lawabb/ESPrinkler2/docs/Screenshot_20190603-192318.png

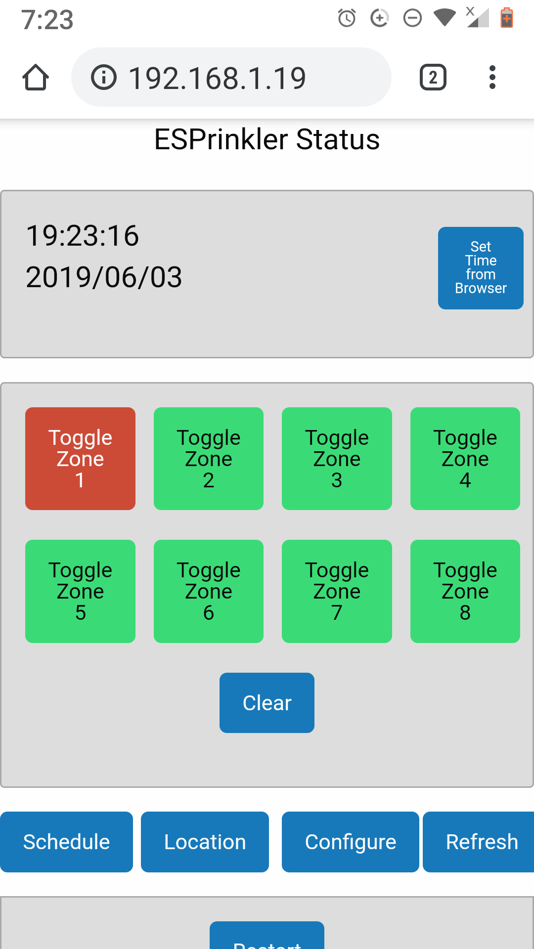
docs/Screenshot_20190603-192318.png
