lawabb/ESPrinkler2/docs/ESPrinkler-Schem_20180705100240.pdf

## VCC

CN4 1

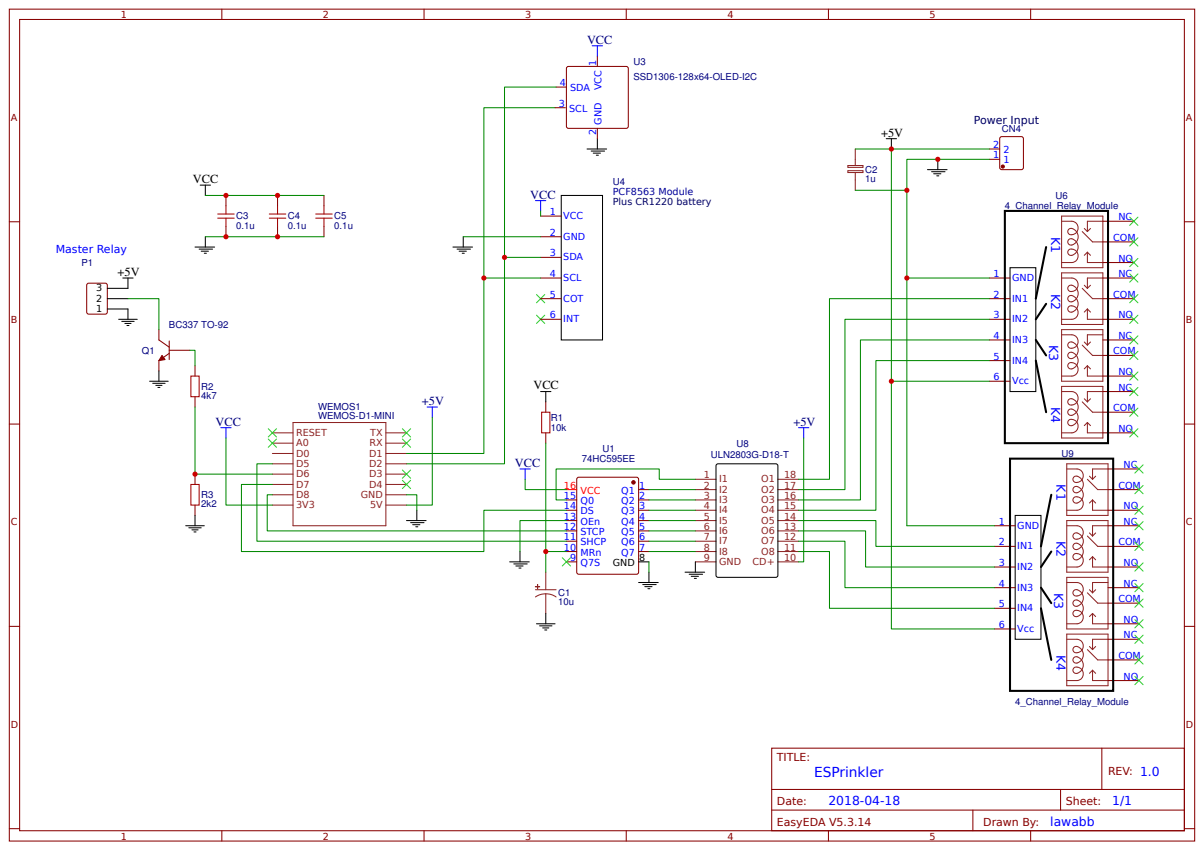
[picture p3: page 1]

9 MRn 10 SHCP 11 STCP 12 OEn 13 DS 14 Q0 15 VCC 16
