lawabb/ESPrinkler2/docs/mini_new_v2_2_0.pdf

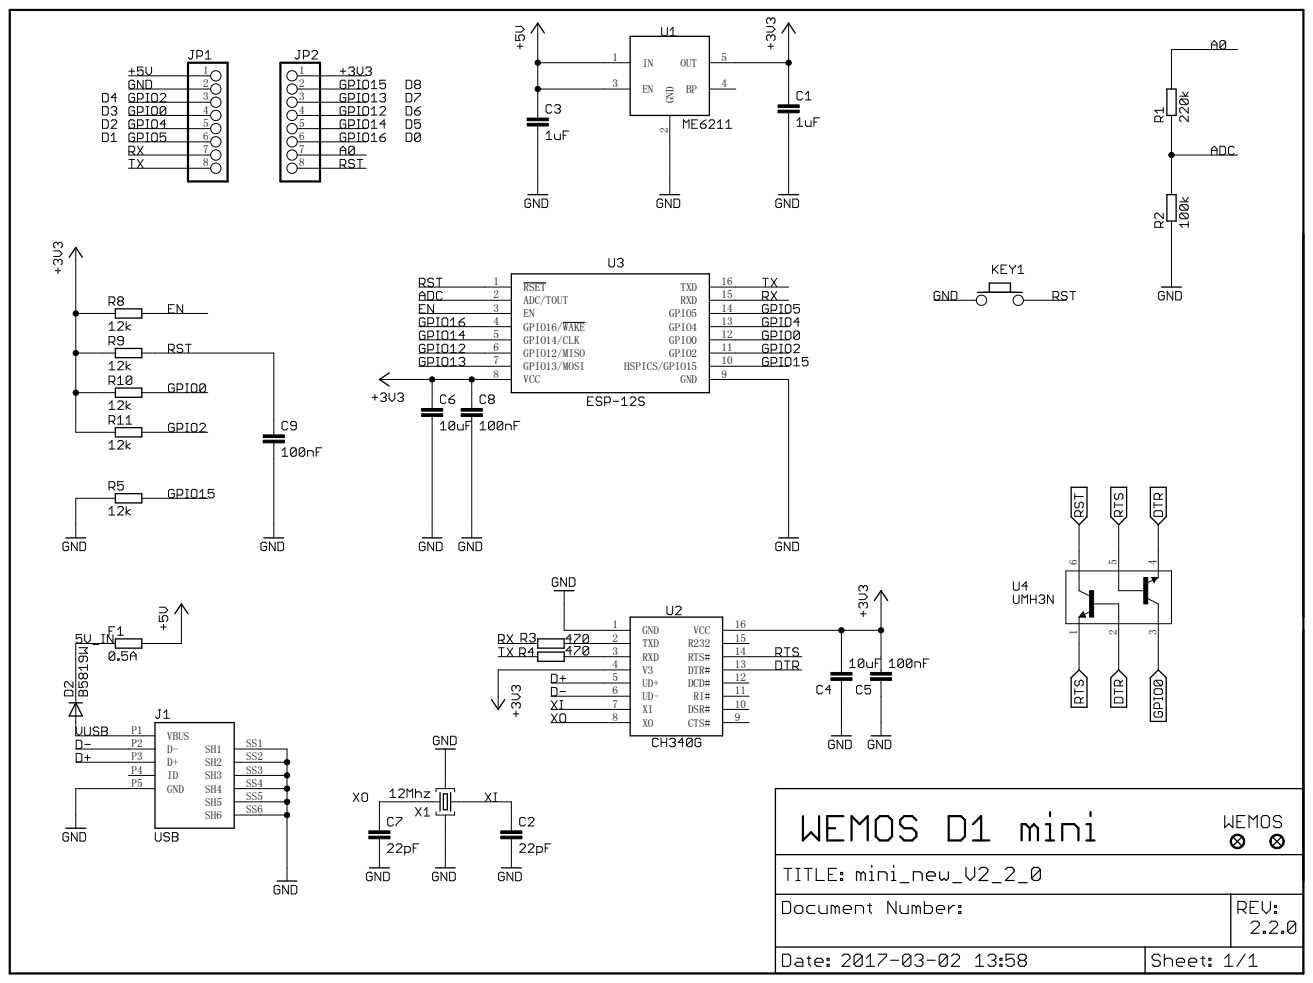
[picture p4: page 1]
