lawabb/ESPrinkler2/ESPrinkler2.ino

/*
 ESPrinkler2 -- Web Server Enabled Sprinkler Controller
 https://github.com/n0bel/ESPrinkler2
 Original Base code is https://github.com/esp8266/Arduino/blob/master/libraries/ESP8266WebServer/examples/FSBrowser/FSBrowser.ino
 Base Code Copyright (c) 2015 Hristo Gochkov. All rights reserved. LGPL
 This Code Copyright (c) 2017 Kevin Uhlir. All rights reserved. LGPL
 This is a rewrite of ESPrinkler https://github.com/n0bel/ESPrinkler but based
 on the Arduino toolchain instead of ExperssIF.  This should make the project
 more accessable to people.
  Minor modifications by Lawrie Abbott 2018. lawabb@gmail.com
*/

/* Requirements:
  Arduino-1.8.5 - this what I used.  Others may be OK
  ESP8266/Arduino :Current Additional Boards Manager URL: https://github.com/esp8266/esp8266.github.io
    Version 2.5.2 https://github.com/esp8266/esp8266.github.io/blob/c6ddb5c67bbc11052dcc4d3c872d92c874f97bed/stable/package_esp8266com_index.json
  ESP8266/Arduino 2.5.2 https://github.com/esp8266/Arduino/releases/tag/2.5.2
  Time 1.5.0 https://github.com/PaulStoffregen/Time
  SimpleTimer https://github.com/jfturcot/SimpleTimer (http://playground.arduino.cc/Code/SimpleTimer)
  NtpClientLib 2.0.5 https://github.com/gmag11/NtpClient
  ArduinoJson 5.6.7 https://github.com/bblanchon/ArduinoJson (https://bblanchon.github.io/ArduinoJson/)
  U8G2Lib 2.13.5 https://github.com/olikraus/u8g2
  orbitalair-arduino-rtc-pcf8563  https://bitbucket.org/orbitalair/arduino_rtc_pcf8563/downloads/ (https://playground.arduino.cc/Main/RTC-PCF8563)

  Don't forget to restart the Arduino IDE after installing these things.

  Set your esp settings.. the board, program method, flash size and spiffs size.

  This uses the SPIFFS file system.  So we need to load that in your esp-xx first.
  Upload the contents of the data folder with MkSPIFFS Tool ("ESP8266 Sketch Data Upload" in Tools menu in Arduino IDE)

  Then compile and upload the .ino.
*/
#define OLED_SCL D1      // D1/GPIO5/SCL to SCL
#define OLED_SDA D2      // D2/GPIO4/SDA to SDA
#define masterRelay D6   // D6/GPIO12 - Use external pulldown to avoid startup pulse 
#define PIN_CLOCK D5     // D5/GPIO14 to SH_CP (pin11 74HC595)
#define PIN_DATA D7      // D7/GPIO13 to DS (pin14 74HC595) 
#define PIN_LATCH D8     // D8/GPIO15 to ST_CP (pin12 74HC595)

#include <U8x8lib.h>
#include <u8g2.h>
#include <U8g2lib.h>
#include <u8x8.h>


// ****** Configurable Options ******

// Include code for PCF8563 RTC
#define INCLUDE_PCF8563

// Include code for DS1307 RTC
//#define INCLUDE_DS1307

// Set display
// See https://github.com/olikraus/u8g2/wiki/u8g2setupcpp#constructor-name
// U8G2_SSD1306_128X64_NONAME_F_HW_I2C(rotation, [reset [, clock, data]])
U8G2_SSD1306_128X64_NONAME_F_HW_I2C u8g2(U8G2_R0, U8X8_PIN_NONE, OLED_SCL, OLED_SDA);

// Where Do you want to send debug output?
#define DBG_OUTPUT_PORT Serial
#define DBG_OUTPUT_PORT_SPEED 115200

// Uncommment if you'd like even more debug information
// #define EXTRA_DEBUG  // arduino-1.8.5/libraries/SimpleTimer/SimpleTimer.h:103:40: error: 'void (* SimpleTimer::callbacks [10])()' is private timer_callback callbacks[MAX_TIMERS];

// ***** End of Config ******


#include <ESP8266WiFi.h>
#include <WiFiClient.h>
#include <ESP8266WebServer.h>
#include <ESP8266mDNS.h>
#include <ArduinoOTA.h>
#include <DNSServer.h>
#include <TimeLib.h>
#include <NtpClientLib.h>
#include <FS.h>..
#include <stdarg.h>

#include <ArduinoJson.h>
#include <string.h>
#include <SimpleTimer.h>
#include <Wire.h>
#include <EEPROM.h>
#define EEPROM_SIZE 512

#ifdef INCLUDE_PCF8563
#include <Rtc_Pcf8563.h>
#endif
#ifdef INCLUDE_DS1307.
#include <RtcDS1307.h>
#endif

#include "./version.h"

#ifdef INCLUDE_PCF8563
Rtc_Pcf8563 Rtc_Pcf8563;
#endif

#ifdef INCLUDE_DS1307
RtcDS1307<TwoWire> Rtc_Ds1307(Wire);
#endif

const char* configFile = "/config.json";   // The config file name
const char* schedFile = "/sched.json";   // The sched file name6
const char* buttonsFile = "/buttons.json";   // The buttons file name

// Note that these are the default values if no /config.json exists,
//  or items are missing from it.

char ssid[31] = { "" };              // This is the access point to connect to
#define EEPROM_SSID 0                 // where the ssid is kept in EEPROM
char password[31] = { "" };           // And its password
#define EEPROM_PASSWORD 32            // where the password is kept in EEPROM
char host[31] = { "*" };               // The host name .local (mdns) hostname
#define EEPROM_HOST 64                // where the host is kept in EEPROM
char assid[31] = { "" };              // This is the access point to connect to
char apassword[31] = { "" };          // And its password

int offsetGMT = 0;                    // Local timezone offset in seconds
char offsetGMTstring[10] = { "-1" };  // String version of it
#define EEPROM_OFFSET_GMT 96          // where the host is kept in EEPROM
int relayState = 0;                   // The current state of the relayState

bool apMode = false;                  // Are we in Acess Point mode?
bool dnsStarted = false;              // Did we start dns?
#ifdef INCLUDE_PCF8563
bool hasPcf8563 = false;              // we found a PCF8563
#endif
#ifdef INCLUDE_DS1307
bool hasDs1307 = false;              // we found a PCF8563
#endif
bool hasRtc = false;                  // do we have an rtc
bool rtcValid  = false;               // does it have a valid time
time_t bootTime = 0;
String bootTimeString;

char timeServer[31] = { "pool.ntp.org" };   // the NTP timeServer to use

#define MAX_SCHED 30
struct _sched {
  int zone;       // 1-8 and 100 for reset
  int days;       // day bits 0-6 = sunday-saturday and 8 and 9 are even and odd
  time_t start;   // seconds like 02:00 am is 120 * 3600
  int duration;   // minutes
  time_t begin;   // begin date
  time_t end;     // end date
  time_t next;    // next time this should turn on a relay
  time_t stop;    // when the relay should turn off
} sched[MAX_SCHED] = { 0 };


// DNS server
const byte DNS_PORT = 53;
DNSServer dnsServer;

ESP8266WebServer server(80);  // The Web Server
File fsUploadFile;            // holds the current upload when files are
                              // uploaded (see edit.htm)
SimpleTimer timer;

int priorPct = -1;
int fullSize = -1;

// format bytes
String formatBytes(size_t bytes) {
  if (bytes < 1024) {
    return String(bytes)+"B";
  } else if (bytes < (1024 * 1024)) {
    return String(bytes/1024.0)+"KB";
  } else if (bytes < (1024 * 1024 * 1024)) {
    return String(bytes/1024.0/1024.0)+"MB";
  } else {
    return String(bytes/1024.0/1024.0/1024.0)+"GB";
  }
}

String getContentType(String filename) {
  if (server.hasArg("download")) return "application/octet-stream";
  else if (filename.endsWith(".htm")) return "text/html";
  else if (filename.endsWith(".html")) return "text/html";
  else if (filename.endsWith(".css")) return "text/css";
  else if (filename.endsWith(".js")) return "application/javascript";
  else if (filename.endsWith(".json")) return "text/json";
  else if (filename.endsWith(".png")) return "image/png";
  else if (filename.endsWith(".gif")) return "image/gif";
  else if (filename.endsWith(".jpg")) return "image/jpeg";
  else if (filename.endsWith(".ico")) return "image/x-icon";
  else if (filename.endsWith(".xml")) return "text/xml";
  else if (filename.endsWith(".pdf")) return "application/x-pdf";
  else if (filename.endsWith(".zip")) return "application/x-zip";
  else if (filename.endsWith(".gz")) return "application/x-gzip";
  return "text/plain";
}

bool handleFileRead(String path) {
  DBG_OUTPUT_PORT.printf(" handleFileRead: %s\n",
    path.c_str());
  displayStatus(2, "served %s", path.c_str());
  if (path.endsWith("/")) path += "index.html";
  String ims = server.header("If-Modified-Since");
  String contentType = getContentType(path);
  String pathWithGz = path + ".gz";
  if (SPIFFS.exists(pathWithGz) || SPIFFS.exists(path)) {
    if (bootTimeString != "" && bootTimeString == ims) {
      server.send(304, contentType, "Not Modified");
      return true;
    }
    if (SPIFFS.exists(pathWithGz))
      path += ".gz";
    File file = SPIFFS.open(path, "r");
    if (path.indexOf(".json") < 0 || path.indexOf("-schema.json") > -1) {
        server.sendHeader("Cache-Control", "public, max-age=3600");
        if (bootTime > 0) {
          server.sendHeader("Last-Modified", bootTimeString);
        }
    } else {
      server.sendHeader("Cache-Control", "public, max-age=0");
    }
    size_t sent = server.streamFile(file, contentType);
    file.close();
    return true;
  }
  DBG_OUTPUT_PORT.printf("%s not found\n", path.c_str());
  return false;
}

void handleFileUpdate() {
  HTTPUpload& update = server.upload();
  if (update.status == UPLOAD_FILE_START) {
    String filename = update.filename;
    fullSize = atoi(server.header("Content-Length").c_str());
    priorPct = 0;
    DBG_OUTPUT_PORT.printf("handleFileUpdate Name: %s %d\n",
      filename.c_str(), fullSize);
    displayStatus(1, "HTTP Update start");
    if (server.uri() == "/spiffsupdate") {
      if (!Update.begin(fullSize, U_SPIFFS)) {
        Update.printError(DBG_OUTPUT_PORT);
      }
    } else {
      uint32_t maxSketchSpace = (ESP.getFreeSketchSpace() - 0x1000)
        & 0xFFFFF000;
      if (!Update.begin(maxSketchSpace)) {
        Update.printError(DBG_OUTPUT_PORT);
      }
    }
  } else if (update.status == UPLOAD_FILE_WRITE) {
    int p = update.totalSize / (fullSize / 100);
    if ((p - priorPct) >= 5) {
      priorPct = p;
      DBG_OUTPUT_PORT.printf("Update: %u%%\n", p);
      displayStatus(1, "HTTP Update %u%", p);
    }
    if (Update.write(update.buf, update.currentSize) != update.currentSize) {
      Update.printError(DBG_OUTPUT_PORT);
      displayStatus(1, "HTTP Update Failed");
    }
  } else if (update.status == UPLOAD_FILE_END) {
    if (Update.end(true)) {
      DBG_OUTPUT_PORT.printf("Update Success: %u\nRebooting...\n",
        update.totalSize);
      displayStatus(1, "HTTP Update End");
    } else {
      Update.printError(DBG_OUTPUT_PORT);
    }
  } else if (update.status == UPLOAD_FILE_ABORTED) {
    Update.end();
    DBG_OUTPUT_PORT.printf("Update aborted.\n");
    displayStatus(1, "HTTP Update aborted");
  }
}
void afterFileUpdate() {
  server.sendHeader("Location",
    String(Update.hasError() ? "/updatefailed.html" :
      "/updatesuccessful.html"), true);
  server.send(301, "text/html", "");
  doRestart();
}

void handleFileUpload() {
  if (server.uri() != "/edit") return;
  HTTPUpload& upload = server.upload();
  if (upload.status == UPLOAD_FILE_START) {
    String filename = upload.filename;
    if (!filename.startsWith("/")) filename = "/"+filename;
    displayStatus(2, "upload %s", filename.c_str());
    DBG_OUTPUT_PORT.printf("handleFileUpload Name: %s\n", filename.c_str());
    fsUploadFile = SPIFFS.open(filename, "w");
    filename = String();
  } else if (upload.status == UPLOAD_FILE_WRITE) {
    // DBG_OUTPUT_PORT.printf("handleFileUpload Data: %s\n",upload.currentSize);
    if (fsUploadFile)
      fsUploadFile.write(upload.buf, upload.currentSize);
  } else if (upload.status == UPLOAD_FILE_END) {
    if (fsUploadFile)
      fsUploadFile.close();
    DBG_OUTPUT_PORT.printf("handleFileUpload Size: %d\n", upload.totalSize);
    if (upload.filename == configFile) {
      loadConfig();
    }
    if (upload.filename == schedFile) {
      loadSched();
    }
  }
}

void handleFileDelete() {
  if (server.args() == 0) return server.send(500, "text/plain", "BAD ARGS");
  String path = server.arg(0);
  DBG_OUTPUT_PORT.printf("handleFileDelete: %s\n", path.c_str());
  displayStatus(2, "deleted %s", path.c_str());
  if (path == "/")
    return server.send(500, "text/plain", "BAD PATH");
  if (!SPIFFS.exists(path))
    return server.send(404, "text/plain", "FileNotFound");
  SPIFFS.remove(path);
  server.send(200, "text/plain", "");
  path = String();
}

void handleFileCreate() {
  if (server.args() == 0)
    return server.send(500, "text/plain", "BAD ARGS");
  String path = server.arg(0);
  DBG_OUTPUT_PORT.printf("handleFileCreate: %s\n", path.c_str());
  displayStatus(2, "created %s", path.c_str());
  if (path == "/")
    return server.send(500, "text/plain", "BAD PATH");
  if (SPIFFS.exists(path))
    return server.send(500, "text/plain", "FILE EXISTS");
  File file = SPIFFS.open(path, "w");
  if (file)
    file.close();
  else
    return server.send(500, "text/plain", "CREATE FAILED");
  server.send(200, "text/plain", "");
  path = String();
}

void handleFileList() {
  if (!server.hasArg("dir")) {
    server.send(500, "text/plain", "BAD ARGS"); return;
  }

  String path = server.arg("dir");
  DBG_OUTPUT_PORT.printf(" handleFileList: %s\n", path.c_str());
  displayStatus(2, "list %s", path.c_str());
  Dir dir = SPIFFS.openDir(path);
  path = String();

  String output = "[";
  while (dir.next()) {
    File entry = dir.openFile("r");
    if (output != "[") output += ',';
    bool isDir = false;
    output += "{\"type\":\"";
    output += (isDir)?"dir":"file";
    output += "\",\"name\":\"";
    output += String(entry.name()).substring(1);
    output += "\"}";
    entry.close();
  }

  output += "]";
  server.sendHeader("Cache-Control", "public, max-age=0");
  server.send(200, "text/json", output);
}

void eeSave();  // forward ref
void loadConfig() {
  if (SPIFFS.exists(configFile)) {
    File file = SPIFFS.open(configFile, "r");
    char json[500];
    memset(json, 0, sizeof(json));
    file.readBytes(json, sizeof(json));
    file.close();
    StaticJsonBuffer<500> jsonBuffer;
    JsonObject& root = jsonBuffer.parseObject(json);
    if (!root.success()) {
        DBG_OUTPUT_PORT.printf("json parse of configFile failed.\n");
    } else {
      const char *t;
      t = root["ssid"]; if (t && t[0] != '*') {
        strncpy(ssid, t, 30);
        t = root["password"]; if (t) { strncpy(password, t, 30); }
      }
      t = root["assid"]; if (t) { strncpy(assid, t, 30); }
      t = root["apassword"]; if (t) { strncpy(apassword, t, 30); }
      t = root["host"]; if (t) { strncpy(host, t, 30); }
      t = root["timeServer"]; if (t) { strncpy(timeServer, t, 30); }
      t = root["offsetGMT"]; if (t) { strncpy(offsetGMTstring, t, 10); }
      int g = atoi(offsetGMTstring);
      if (g != -1) {
        offsetGMT = g;
      }
      setHostName();
      displayStatus(2, host);
      eeSave();
      DBG_OUTPUT_PORT.printf("Config: host: %s ssid: %s assid: %s\n",
        host, ssid, assid);
      DBG_OUTPUT_PORT.printf("  timeServer: %s offsetGMT:%d\n",
        timeServer, offsetGMT);
    }
  } else {
    DBG_OUTPUT_PORT.printf("config file: %s not found\n", configFile);
  }
}

int computeDayFromTm(tmElements_t *tm) {
  // bits 0-6 = day of week
  // bits 8 == even Day
  // bit 9 == odd Day
  return (1 << (tm->Wday - 1)) | ( 1 << ((tm->Day & 1) + 8));
}

#ifdef EXTRA_DEBUG
void dumpSched(const char *m, struct _sched *s) {
  DBG_OUTPUT_PORT.printf(
    "%s: %08x z:%d s:%d d:%02x b:%d e:%d n:%d o:%d d:%d\n",
    m, s, s->zone, s->start, s->days, s->begin, s->end,
    s->next, s->stop, s->duration);
    DBG_OUTPUT_PORT.printf("%s: next:%s",
      m, timeStr(s->next+offsetGMT));
    DBG_OUTPUT_PORT.printf(" stop:%s\n", timeStr(s->stop+offsetGMT));
}
#endif

void xxdoRestart() {
  ESP.restart();
}

void doRestart() {
  displayStatus(0, "Restarting.....");
  DBG_OUTPUT_PORT.printf("Restart in 5 seconds.\n");
  timer.setTimeout(5000, []() { ESP.restart(); });
}
void computeNext(struct _sched *s) {
  if (now() < 10000000) {
    s->next = s->stop = 0;
    return;
  }
  time_t midnightLocal = (now() + offsetGMT) / 86400;
  if (s->begin > 10000000 && s->begin > now())
    midnightLocal = s->begin / 86400;
  midnightLocal = midnightLocal * 86400;
  time_t midnightLocalAsGmt = midnightLocal - offsetGMT;
  int day = 0xffff;
  s->next = midnightLocalAsGmt + s->start - 86400;
  do {
    s->next += 86400;
    tmElements_t tm;
    breakTime(s->next + offsetGMT, tm);
    day = computeDayFromTm(&tm);
    if (s->next > s->end) {
      s->next = 0;
      break;
    }
    #ifdef EXTRA_DEBUG
    dumpSched("computeNext", s);
    DBG_OUTPUT_PORT.printf("computeNext: day=%02x tm.Day=%d tm.Wday=%d\n",
      day, tm.Day, tm.Wday);
    #endif
  } while (now() >= s->next
      || (day & (s->days)) == 0);
  if (s->stop == 0 && s->next > 0) {
    s->stop = s->next + s->duration;
  }
}

void checkSched() {
  time_t timeNow = now();
  for (int i = 0; i < MAX_SCHED; i++) {
    if (sched[i].zone > 0) {
      #ifdef EXTRA_DEBUG
      dumpSched("checkSched", &sched[i]);
      #endif
      if (sched[i].stop > 0 && timeNow >= sched[i].stop) {
        sched[i].stop = 0;
        if (sched[i].next > 0) {
          sched[i].stop = sched[i].next + sched[i].duration;
        }
        if (sched[i].zone < 9) {
          relayState &= ~(1 << (sched[i].zone - 1));
          setRelays();
        }
      }
      if (sched[i].next > 0 && timeNow >= sched[i].next) {
        if (sched[i].zone == 100) {
          doRestart();
        } else {
          relayState |= (1 << (sched[i].zone - 1));
          setRelays();
        }
        computeNext(&sched[i]);
      }
    }
  }
}

void recalcSched() {
  for (int i = 0; i < MAX_SCHED; i++) {
    if (sched[i].zone > 0) {
      computeNext(&sched[i]);
    }
  }
}

void loadSched() {
  if (SPIFFS.exists(schedFile)) {
    File file = SPIFFS.open(schedFile, "r");
    char json[1000];
    memset(json, 0, sizeof(json));
    file.readBytes(json, sizeof(json));
    file.close();
    StaticJsonBuffer<1000> jsonBuffer;
    JsonArray& root = jsonBuffer.parseArray(json);
    if (!root.success()) {
        DBG_OUTPUT_PORT.printf("json parse of schedFile failed.\n");
    } else {
      tmElements_t tm;
      relayState = 0;
      setRelays();
      for (int i = 0; i < MAX_SCHED; i++) {
        const char *zoneString = root[i]["zone"];
        const char *startTime = root[i]["startTime"];
        sched[i].zone = 0;
        sched[i].next = 0;
        sched[i].duration = 0;
        sched[i].stop = 0;
        if (zoneString && zoneString[0] != '\0'
            && startTime && startTime[0] != '\0') {
//
          if (strstr(zoneString, "Zone ") == zoneString) {
            sched[i].zone = zoneString[5] - '0';
          }

          if (strstr(zoneString, "Restart") == zoneString) {
            sched[i].zone = 100;
          }

          sched[i].start = atoi(startTime) * 3600 +
                           atoi(startTime + 3) * 60;

          const char *beginDate = root[i]["begin"];
          if (!beginDate || beginDate[0] == '\0') {
            sched[i].begin = 10000000;   // more or less beginning of time
          } else  {
            tm.Second = tm.Hour = tm.Minute = tm.Wday = 0;
            tm.Year = atoi(beginDate) - 1970;
            tm.Month = atoi(beginDate+5);
            tm.Day = atoi(beginDate+8);
            sched[i].begin = makeTime(tm) - offsetGMT;
          }

          const char *endDate = root[i]["end"];
          if (!endDate || endDate[0] == '\0') {
            sched[i].end = 0x7fffffff;   // more or less end of time
          } else {
            tm.Second = tm.Hour = tm.Minute = tm.Wday = 0;
            tm.Year = atoi(endDate) - 1970;
            tm.Month = atoi(endDate+5);
            tm.Day = atoi(endDate+8);
            sched[i].end = makeTime(tm) - offsetGMT;
          }

          const char *duration = root[i]["duration"];
          if (!duration || duration[0] == '\0') {
            sched[i].duration = 15 * 60;  // default = 15 minutes
          } else {
            sched[i].duration = atoi(duration) * 60;
          }


          sched[i].days = 0;
          for (int j = 0; j < 10; j++) {
            const char *dayString = root[i]["days"][j];
            if (!dayString) break;
            if (strstr(dayString, "Sunday") == dayString )
              sched[i].days |= 1 << 0;
            if (strstr(dayString, "Monday") == dayString )
              sched[i].days |= 1 << 1;
            if (strstr(dayString, "Tuesday") == dayString )
              sched[i].days |= 1 << 2;
            if (strstr(dayString, "Wednesday") == dayString )
              sched[i].days |= 1 << 3;
            if (strstr(dayString, "Thursday") == dayString )
              sched[i].days |= 1 << 4;
            if (strstr(dayString, "Friday") == dayString )
              sched[i].days |= 1 << 5;
            if (strstr(dayString, "Saturday") == dayString )
              sched[i].days |= 1 << 6;
            if (strstr(dayString, "Even") == dayString )
              sched[i].days |= 1 << 8;
            if (strstr(dayString, "Odd") == dayString )
            sched[i].days |= 1 << 9;
          }
          if (sched[i].days == 0) sched[i].days = 0xffff;

          computeNext(&sched[i]);

          #ifdef EXTRA_DEBUG
          dumpSched("schedlist", &sched[i]);
          #endif
          DBG_OUTPUT_PORT.printf("schedule %d loaded next: %s duration %d\n",
              i, timeStr(sched[i].next + offsetGMT), sched[i].duration);
        }
      }
    }
  } else {
    DBG_OUTPUT_PORT.printf("sched file: %s not found\n", schedFile);
  }
}

void setRelays() {
  DBG_OUTPUT_PORT.printf("set relays=%02x\n", relayState);

  // masterRelay comes on whenever any of relays 1 - 8 are active
  // Using D6 as it is the only PIN available that can be held LOW on startup
  if (relayState > 0) {
    digitalWrite(masterRelay, HIGH);
  } else {
    digitalWrite(masterRelay, LOW);
  }

  // Use simple shiftOut instead of SPI to free up D6
  digitalWrite(PIN_LATCH, LOW);
  shiftOut(PIN_DATA, PIN_CLOCK, MSBFIRST, relayState);
  digitalWrite(PIN_LATCH, HIGH);

  u8g2.setDrawColor(0);
  u8g2.drawBox(0, 64 - 12, 128, 12);
  for (int i = 0; i < 8; i++) {
    if (relayState & (1 << i)) {
      u8g2.setDrawColor(1);
      u8g2.drawBox(i * 16 + 2, 64 - 12, 12, 12);
      u8g2.setDrawColor(0);
      u8g2.drawGlyph(i * 16 + 6, 64 - 11, i + '1');
    } else {
      u8g2.setDrawColor(0);
      u8g2.drawBox(i * 16 + 2, 64 - 12, 12, 12);
      u8g2.setDrawColor(1);
      u8g2.drawGlyph(i * 16 + 6, 64 - 11, i + '1');
    }
  }
  u8g2.sendBuffer();
}

void displayStatus(int line, const char *fmt, ...) {
  int count;
  char *buffer;
  va_list Arglist;

  count = 0;
  buffer = reinterpret_cast<char*>(malloc(128));
  if (buffer == NULL) return;
  va_start(Arglist, fmt);
  vsnprintf(buffer, 128, fmt, Arglist); // NOLINT

  u8g2.setDrawColor(0);
  u8g2.drawBox(0, line * 12, 128, 12);
  u8g2.setDrawColor(1);
  u8g2.drawStr(0, line * 12, buffer);
  u8g2.sendBuffer();
  free(buffer);
}

void clearTimedFunc(int *id, const char *name) {
  DBG_OUTPUT_PORT.printf("clearTimedFunc %s\n", name);
  if (*id > -1) {
    DBG_OUTPUT_PORT.printf("clearingTimer id=%d\n", *id);
    timer.disable(*id);
    timer.deleteTimer(*id);
  }
  *id = -1;
}

int setTimedFunc(bool repeat, int *id, sint32_t t,
    void (*func)(), const char *name) {
  if (*id > -1) {
    #ifdef EXTRA_DEBUG
    DBG_OUTPUT_PORT.printf("clearingTimer id=%d\n", *id);
    #endif
    timer.disable(*id);
    timer.deleteTimer(*id);
  }
  *id = -1;
  if (t > 0) {
    if (repeat) {
      *id = timer.setInterval(t, func);
    } else {
      *id = timer.setTimeout(t, func);
    }
  }
  #ifdef EXTRA_DEBUG
  DBG_OUTPUT_PORT.printf("setTimedFunc %d %d %s %08x id=%d\n",
    repeat, t, name, func, *id);
  for (int i = 0; i < timer.MAX_TIMERS; i++) {
    if (timer.callbacks[i]) {
      DBG_OUTPUT_PORT.printf("%d cb:%08x num:%d numMax:%d\n",
        i, timer.callbacks[i], timer.numRuns[i], timer.maxNumRuns[i]);
    }
  }
  #endif
  return(*id);
}

// LED CONTROL
int blinkerTimerId = -1;
#define setBlinker(t) setTimedFunc(true, &blinkerTimerId, t, blinker, "blinker")
void blinker() {
  static bool onoff = false;
  onoff = !onoff;
  digitalWrite(BUILTIN_LED, onoff?HIGH:LOW);
}

// mdns
bool mdnsStarted = false;
void startMDNS() {
  if (mdnsStarted) return;
  mdnsStarted = true;
  MDNS.begin(host);
  DBG_OUTPUT_PORT.printf("MDNS Starting\nOpen http://%s.local or http://%s/\n",
    host, apMode ? WiFi.softAPIP().toString().c_str() :
                   WiFi.localIP().toString().c_str());
  displayStatus(2, host);
}

// NTP

void setRtc() {
  #ifdef INCLUDE_PCF8563
  if (hasPcf8563) {
    Rtc_Pcf8563.setDate(day(), weekday() - 1, month(), year() < 2000 ? 1 : 0,
      year()%100);
    Rtc_Pcf8563.setTime(hour(), minute(), second());
    DBG_OUTPUT_PORT.printf("Setting PCF8563 time.\n");
  }
  #endif
  #ifdef INCLUDE_DS1307
  if (hasDs1307) {
    RtcDateTime dt = RtcDateTime(
      year(), month(), day(), hour(), minute(), second());
    Rtc_Ds1307.SetDateTime(dt);
    DBG_OUTPUT_PORT.printf("Setting DS1307 time.\n");
  }
  #endif
}

bool ntpStarted = false;
void startNTP() {
    if (timeServer[0] == '\0') return;
    if (rtcValid) return;
    if (ntpStarted) return;
    ntpStarted = true;
    DBG_OUTPUT_PORT.printf("Starting NTP %s\n", timeServer);
    NTP.begin(timeServer, 0, false);
}
void stopNTP() {
    NTP.stop();
    ntpStarted = false;
}
void recalcSched();  // forward ref
void handleNtpSync(NTPSyncEvent_t event) {
  if (event) {
    DBG_OUTPUT_PORT.printf("NTP Error %d\n", event);
  } else {
    DBG_OUTPUT_PORT.printf("NTP Successfull\n");
    timer.setTimeout(1000, recalcSched);
    if (hasRtc && !rtcValid) {
        timer.setTimeout(1000, setRtc);
        stopNTP();
    }
  }
}

const char *timeStr(time_t t) {
  static char tmbuf[20];
  if (t < 10000000) {
    strncpy(tmbuf, "Not Set", sizeof(tmbuf));
    return tmbuf;
  }
  tmElements_t tm;
  breakTime(t, tm);
  snprintf(tmbuf, sizeof(tmbuf), "%02d:%02d:%02d %04d/%02d/%02d",
    tm.Hour, tm.Minute, tm.Second, tm.Year + 1970, tm.Month, tm.Day);
  return tmbuf;
}

const char *timeStrStd(time_t t) {
  static char tmbuf[40];
  static char *wdays[7] = {
    "Sun", "Mon", "Tue", "Wed", "Thu", "Fri", "Sat"
  };
  static char *mons[12] = {
    "Jan", "Feb", "Mar", "Apr", "May", "Jun",
    "Jul", "Aug", "Sep", "Oct", "Nov", "Dec"
  };
  tmElements_t tm;
  breakTime(t, tm);
  snprintf(tmbuf, sizeof(tmbuf), "%s, %02d %s %04d %02d:%02d:%02d GMT",
    wdays[tm.Wday - 1], tm.Day, mons[tm.Month - 1], tm.Year + 1970,
    tm.Hour, tm.Minute, tm.Second);
  return tmbuf;
}


int tickId = -1;
void checkSched();  // forward ref
void tick() {
  const char *tx = timeStr(now() > 100000000 ? now()+offsetGMT : 0);
  #ifdef EXTRA_DEBUG
    DBG_OUTPUT_PORT.printf("now(): %d %s\n", now(), tx);
  #endif
  displayStatus(1, "time %s\n", tx);
  if (bootTime == 0 && now() > 100000000) {
    bootTime = now();
    bootTimeString = String(timeStrStd(bootTime));
    DBG_OUTPUT_PORT.printf("boot time: %s\n", bootTimeString.c_str());
  }

  checkSched();
}

// WIFI STATUS CHANGES

void setHostName() {
  if (host[0] == '*' && host[1] == '\0') {
    uint8_t mac[6];
    WiFi.softAPmacAddress(mac);
    snprintf(host, sizeof(host), "ESPrinkler2_%02x%02x%02x",
      mac[3], mac[4], mac[5]);
  }
}

int apModeTimerId = -1;
int staModeTimerId = -1;
#define setApModeTimeout(t) \
  setTimedFunc(false, &apModeTimerId, t, apModeTimeout, "apModeTimeout")
#define setStaModeTimeout(t) \
  setTimedFunc(false, &staModeTimerId, t, staModeTimeout, "staModeTimeout")
void apModeTimeout() {
  DBG_OUTPUT_PORT.printf("apModeTimeout\n");
  apModeTimerId = -1;
  setApMode(true);
  setBlinker(100);
  if (ssid[0] != '\0') {   // if no ssid
    setStaModeTimeout(600000);
  }
}

void staModeTimeout() {
  DBG_OUTPUT_PORT.printf("staModeTimeout\n");
  staModeTimerId = -1;
  setApMode(false);
  setBlinker(50);
  setApModeTimeout(60000);
}

void setApMode(bool mode) {
    if (apMode == mode) return;
    apMode = mode;
    if (apMode) {
      DBG_OUTPUT_PORT.printf("going to AP mode\n");
      WiFi.disconnect();
      delay(500);
      WiFi.mode(WIFI_AP);
      apMode = true;
      uint8_t mac[6];
      delay(500);
      WiFi.softAPmacAddress(mac);
      delay(500);
      if (assid[0] == '\0') {
        strncpy(assid, host, sizeof(assid));
      }
      DBG_OUTPUT_PORT.printf("SoftAP ssid:%s\n", assid);
      if (strlen(apassword) >= 8) {  // softAP doesn't work if password < 8
        WiFi.softAP(assid, apassword);
      } else {
        WiFi.softAP(assid);
      }
      DBG_OUTPUT_PORT.printf("AP mode. IP address: %s\n",
        WiFi.softAPIP().toString().c_str());

      /* Setup the DNS server redirecting all the domains to the apIP */
      dnsServer.setErrorReplyCode(DNSReplyCode::NoError);
      dnsServer.start(DNS_PORT, "*", WiFi.softAPIP());
      dnsStarted = true;

      #ifdef EXTRA_DEBUG
      WiFi.printDiag(DBG_OUTPUT_PORT);
      #endif
      displayStatus(0, "AP:%s %s", WiFi.softAPIP().toString().c_str(), assid);
    } else {
      if (dnsStarted) dnsServer.stop();
      dnsStarted = false;
      DBG_OUTPUT_PORT.printf("going to STA mode %s\n", ssid);
      displayStatus(0, "Try: %s", ssid);
      WiFi.mode(WIFI_STA);
      delay(500);
      if (password[0] == '\0') {
        WiFi.begin(ssid);
      } else {
        WiFi.begin(ssid, password);
      }
    }
}

WiFiEventHandler onSTAGotIPHandler;
void onSTAGotIP(WiFiEventStationModeGotIP ipInfo) {
  if (apMode) return;
  DBG_OUTPUT_PORT.printf("Got IP: %s\n", ipInfo.ip.toString().c_str());
  displayStatus(0, "STA:%s %s %d", WiFi.localIP().toString().c_str(),
      ssid, WiFi.RSSI());
  setApModeTimeout(0);
  setBlinker(500);
  timer.setTimeout(1000, startMDNS);
  timer.setTimeout(5000, startNTP);
}

WiFiEventHandler onSTADisconnectedHandler;
void onSTADisconnected(WiFiEventStationModeDisconnected event_info) {
  if (apMode) return;
  Serial.printf("Disconnected from SSID: %s Reason: %d\n",
    event_info.ssid.c_str(), event_info.reason);
  displayStatus(0, "DIS:%s %d", event_info.ssid.c_str(), event_info.reason);
  setBlinker(50);
  if (apModeTimerId < 0) setApModeTimeout(600000);
  timer.setTimeout(20, stopNTP);
}


bool eeIsValid() {
  uint8_t csum = 0x35;
  #ifdef EXTRA_DEBUG
  DBG_OUTPUT_PORT.printf("eeIsValid?");
  #endif
  for (int addr = 0; addr < EEPROM_SIZE; addr++) {
    #ifdef EXTRA_DEBUG
    DBG_OUTPUT_PORT.printf(" %02x", EEPROM.read(addr));
    #endif
    csum += EEPROM.read(addr);
  }
  #ifdef EXTRA_DEBUG
  DBG_OUTPUT_PORT.printf("eeIsValid CSUM=%02x\n", csum);
  #endif
  if (csum != 0) return false;
  return true;
}

bool eeMakeValid() {
  uint8_t csum = 0x35;
  for (int addr = 0; addr < (EEPROM_SIZE-1); addr++) {
    csum += EEPROM.read(addr);
  }
  #ifdef EXTRA_DEBUG
  DBG_OUTPUT_PORT.printf("eeMakeValid last=%02x\n", 256 - csum);
  #endif
  EEPROM.write(EEPROM_SIZE-1, 256 - csum);
  EEPROM.commit();
}


void eeReadChar(char *data, int addr, int size) {
  while (size--) {
    *data = static_cast<char>(EEPROM.read(addr));
    addr++;
    data++;
  }
}

void eeWriteChar(char *data, int addr, int size) {
  while (size--) {
    EEPROM.write(addr, (uint8_t)*data);
    addr++;
    data++;
  }
}

void eeClear() {
  for (int addr = 0; addr < (EEPROM_SIZE-1); addr++) {
    EEPROM.write(addr, 0);
  }
  eeMakeValid();
}

void eeLoad() {
  eeReadChar(ssid, EEPROM_SSID, sizeof(ssid));
  eeReadChar(password, EEPROM_PASSWORD, sizeof(password));
  char t[sizeof(host)];
  eeReadChar(t, EEPROM_HOST, sizeof(host));
  if (strlen(t) > 0) strncpy(host, t, sizeof(host));
  setHostName();
  displayStatus(2, host);
  eeReadChar(offsetGMTstring, EEPROM_OFFSET_GMT, sizeof(offsetGMTstring));
  offsetGMT = atoi(offsetGMTstring);
}

void eeSave() {
  if (ssid[0] != '\0' && ssid[0] != '*') {
    eeWriteChar(ssid, EEPROM_SSID, sizeof(ssid));
    eeWriteChar(password, EEPROM_PASSWORD, sizeof(password));
  }
  eeWriteChar(host, EEPROM_HOST, sizeof(host));
  snprintf(offsetGMTstring, sizeof(offsetGMTstring), "%d", offsetGMT);
  eeWriteChar(offsetGMTstring, EEPROM_OFFSET_GMT, sizeof(offsetGMTstring));
  eeMakeValid();
}

void setup(void) {
  // Add master relay output to come on whenever
  // any output relay is on.

  pinMode(masterRelay, OUTPUT);
  pinMode(PIN_LATCH, OUTPUT);
  pinMode(PIN_DATA, OUTPUT);
  pinMode(PIN_CLOCK, OUTPUT);
  
  digitalWrite(masterRelay, LOW);
  
  pinMode(BUILTIN_LED, OUTPUT);
  setBlinker(50);
  
  // digitalWrite(PIN_LATCH, LOW);
  // shiftOut(PIN_DATA, PIN_CLOCK, MSBFIRST, relayState);
  // digitalWrite(PIN_LATCH, HIGH);

  delay(500);
  DBG_OUTPUT_PORT.begin(DBG_OUTPUT_PORT_SPEED);
  DBG_OUTPUT_PORT.setDebugOutput(false);
  #ifdef EXTRA_DEBUG
  DBG_OUTPUT_PORT.setDebugOutput(true);
  #endif
  DBG_OUTPUT_PORT.printf("\n\nESPrinkler2 %s compiled %s %s\n",
    VERSION, __DATE__, __TIME__);

  DBG_OUTPUT_PORT.setTimeout(1000);
  u8g2.begin();
  u8g2.setFont(u8g2_font_helvR08_tf);
  u8g2.setFontRefHeightExtendedText();
  u8g2.setDrawColor(1);
  u8g2.setFontPosTop();
  u8g2.setFontDirection(0);
  u8g2.clearBuffer();
  displayStatus(0, "Start %s", VERSION);
  displayStatus(1, "cmp: %s %s", __DATE__, __TIME__);
  setHostName();
  displayStatus(2, host);

  delay(2000);

  EEPROM.begin(EEPROM_SIZE);
  if (eeIsValid()) {
    eeLoad();
  } else {
    eeClear();
    eeSave();
  }

  SPIFFS.begin();
  {
    Dir dir = SPIFFS.openDir("/");
    while (dir.next()) {
      String fileName = dir.fileName();
      size_t fileSize = dir.fileSize();
      DBG_OUTPUT_PORT.printf("FS File: %s, size: %s\n",
        fileName.c_str(), formatBytes(fileSize).c_str());
    }
    DBG_OUTPUT_PORT.printf("\n");
  }


  loadConfig();

  #ifdef EXTRA_DEBUG
  for (int address = 1; address < 127; address++) {
    // The i2c_scanner uses the return value of
    // the Write.endTransmisstion to see if
    // a device did acknowledge to the address.
    Wire.beginTransmission(address);
    int error = Wire.endTransmission();

    if (error == 0) {
      DBG_OUTPUT_PORT.printf("I2C device found at address 0x%02x\n", address);
    } else {
      if (error == 4) {
        DBG_OUTPUT_PORT.printf("Unknown error at address 0x%02x\n", address);
      }
    }
  }
  #endif

  // DS1307
  #ifdef INCLUDE_DS1307
  Wire.beginTransmission(DS1307_ADDRESS);
  if (Wire.endTransmission() == 0) {
    hasRtc = true;
    hasDs1307 = true;
    DBG_OUTPUT_PORT.printf("RTC DS1307 Found @ %02x\n", DS1307_ADDRESS);
    displayStatus(0, "RTC found");
    if (Rtc_Ds1307.GetIsRunning()) {
      if (Rtc_Ds1307.IsDateTimeValid()) rtcValid = true;
    } else {
      DBG_OUTPUT_PORT.printf("RTC DS1307 is not running.\n");
      Rtc_Ds1307.SetIsRunning(true);
      DBG_OUTPUT_PORT.printf("Set RTC DS1307 to running.\n");
    }
    RtcDateTime dt = Rtc_Ds1307.GetDateTime();
    DBG_OUTPUT_PORT.printf(
      "RTC DS1307 time is %svalid: %02d:%02d:%02d %04d/%02d/%02d\n",
      rtcValid ? "" : "not ", dt.Hour(), dt.Minute(), dt.Second(),
        dt.Year(), dt.Month(), dt.Day());
    if (rtcValid) {
      setTime(dt.Hour(), dt.Minute(), dt.Second(),
        dt.Day(), dt.Month(), dt.Year());
    }
  }
  #endif

  // pcf8563
  #ifdef INCLUDE_PCF8563
  Wire.beginTransmission(RTCC_R>>1);
  if (Wire.endTransmission() == 0) {
    hasRtc = true;
    hasPcf8563 = true;
    DBG_OUTPUT_PORT.printf("RTC PCF8563 Found @ %02x\n", RTCC_R>>1);
    displayStatus(0, "RTC found");
    Wire.beginTransmission(RTCC_R>>1);
    Wire.write(RTCC_STAT1_ADDR);
    Wire.endTransmission();
    Wire.requestFrom(RTCC_R >> 1, 3);   // request 3 bytes
    byte stat1 = Wire.read();
    byte stat2 = Wire.read();
    byte stat3 = Wire.read();
    DBG_OUTPUT_PORT.printf("RTC PCF8563 status %02x %02x %02x\n",
      stat1, stat2, stat3);
    // we'll init the control values 1 and 2
    Wire.beginTransmission(RTCC_R>>1);
    Wire.write(RTCC_STAT1_ADDR);
    Wire.write(0);
    Wire.write(0);
    Wire.endTransmission();

    if ((stat1  & (1 << 7 | 1 << 5)) == 0) {  // if clock is running
      if ((stat3 & 0x80) == 0) rtcValid = true;
    }
    if (!rtcValid) {
      displayStatus(0, "RTC not valid");
    }
    DBG_OUTPUT_PORT.printf("RTC PCF8563 time is %svalid: %s %s\n",
      rtcValid ? "" : "not ", Rtc_Pcf8563.formatDate(RTCC_DATE_ASIA),
      Rtc_Pcf8563.formatTime(RTCC_TIME_HMS));
    if (rtcValid) {
      setTime(Rtc_Pcf8563.getHour(), Rtc_Pcf8563.getMinute(),
       Rtc_Pcf8563.getSecond(), Rtc_Pcf8563.getDay(),
       Rtc_Pcf8563.getMonth(), 2000 + Rtc_Pcf8563.getYear());
    }
  }
  #endif

  loadSched();

  setRelays();

  // WIFI INIT

  onSTAGotIPHandler = WiFi.onStationModeGotIP(onSTAGotIP);
  onSTADisconnectedHandler = WiFi.onStationModeDisconnected(onSTADisconnected);
  NTP.onNTPSyncEvent(handleNtpSync);
  WiFi.persistent(false);
  if (ssid[0] == '\0')  {   // no ssid, therefore go to apmode
    apMode = false;  // forced mode change
    setApMode(true);
  } else {
    setApModeTimeout(60000);
    apMode = true;  // forced mode change
    setApMode(false);
  }

  setTimedFunc(true, &tickId, 1000, tick, "tick");

// SERVER INIT
  // list directory
  server.on("/list", HTTP_GET, handleFileList);
  // load editor
  server.on("/edit", HTTP_GET, []() {
    if (!handleFileRead("/edit.html")) {
      server.send(404, "text/plain", "FileNotFound");
    }
  });
  // create file
  server.on("/edit", HTTP_PUT, handleFileCreate);
  // delete file
  server.on("/edit", HTTP_DELETE, handleFileDelete);
  // first callback is called after the request has
  // ended with all parsed arguments
  // second callback handles file uploads at that location
  server.on("/edit", HTTP_POST,
    []() { server.send(200, "text/plain", ""); },
    handleFileUpload);

  server.on("/update", HTTP_POST,
    afterFileUpdate,
    handleFileUpdate);
  server.on("/spiffsupdate", HTTP_POST,
      afterFileUpdate,
      handleFileUpdate);


  server.on("/status", HTTP_GET, []() {
    displayStatus(2, "%s", server.uri().c_str());
    String json = "{";
    for (int i = 0; i < 8; i++) {
      json += String("\"zone") +
        String(i) +
        String(relayState&(1 << i) ? "\":\"on\"," : "\":\"off\",");
    }
    json += String("\"time\":")+String(now())+",";
    json += String("\"offsetGMT\":")+String(offsetGMT)+",";
    json += String("\"host\":\"")+String(host)+"\"";
    json += "}";
    server.sendHeader("Cache-Control", "public, max-age=0");
    server.send(200, "text/json", json);
    DBG_OUTPUT_PORT.printf("status %s\n", json.c_str());
    json = String();
  });

  server.on("/toggle", HTTP_GET, []() {
    displayStatus(2, "%s", server.uri().c_str());
    int i = 0;
    if (server.args() > 0)
      i = atoi(server.arg("zone").c_str());
    relayState ^= (1 << i);
    server.sendHeader("Cache-Control", "public, max-age=0");
    server.send(200, "text/text", "OK");
    DBG_OUTPUT_PORT.printf("toggle %d = %s\n", i,
      relayState&(1 << i) ? "on" : "off");
    setRelays();
  });

  server.on("/clear", HTTP_GET, []() {
    displayStatus(2, "%s", server.uri().c_str());
    relayState = 0;
    server.sendHeader("Cache-Control", "public, max-age=0");
    server.send(200, "text/text", "OK");
    setRelays();
  });

  server.on("/clean", HTTP_GET, []() {
    displayStatus(2, "%s", server.uri().c_str());
    eeClear();
    SPIFFS.remove(configFile);
    SPIFFS.remove(schedFile);
    SPIFFS.remove(buttonsFile);
    server.sendHeader("Cache-Control", "public, max-age=0");
    server.send(200, "text/text", "Persistant Storage has been cleaned.");
  });

  server.on("/settime", HTTP_GET, []() {
    displayStatus(2, "%s", server.uri().c_str());
    int i = 0;
    i = atoi(server.arg("time").c_str());
    setTime(i);
    i = atoi(server.arg("offset").c_str());
    offsetGMT = i;
    if (hasRtc) {
      setRtc();
    }
    eeSave();
    server.sendHeader("Cache-Control", "public, max-age=0");
    server.send(200, "text/text", "OK");
    DBG_OUTPUT_PORT.printf("settime %d\n", i);
    setRelays();
  });

  server.on("/restart", HTTP_GET, []() {
    displayStatus(2, "%s", server.uri().c_str());
    server.sendHeader("Cache-Control", "public, max-age=0");
    server.send(200, "text/text",
      "Restarting.... Wait a minute or so and then refresh.");
    relayState = 0;
    setRelays();
    doRestart();
  });

  // called when the url is not defined here
  // use it to load content from SPIFFS
  server.onNotFound([]() {
    if (!handleFileRead(server.uri())) {
      displayStatus(2, "not found %s", server.uri().c_str());
      server.send(404, "text/plain", "FileNotFound");
    }
  });

  const char * headerkeys[] = {"If-Modified-Since", "Content-Length"};
  server.collectHeaders(headerkeys, 2);
  server.begin();
  DBG_OUTPUT_PORT.printf("HTTP server started\n");

  // OTA init
  ArduinoOTA.onStart([]() {
    priorPct = 0;
    DBG_OUTPUT_PORT.printf("OTA Start\n");
    displayStatus(1, "OTA Update Start.");
  });
  ArduinoOTA.onEnd([]() {
    DBG_OUTPUT_PORT.printf("OTA End\n");
    displayStatus(1, "OTA done.");
  });
  ArduinoOTA.onProgress([](unsigned int progress, unsigned int total) {
    int p = progress / (total / 100);
    if ((p - priorPct) < 5) return;
    priorPct = p;
    DBG_OUTPUT_PORT.printf("OTA Update: %u%%\r\n", p);
    displayStatus(1, "OTA Update: %u%%", p);
  });
  ArduinoOTA.onError([](ota_error_t error) {
    DBG_OUTPUT_PORT.printf("Error[%u]: ", error);
    if (error == OTA_AUTH_ERROR) DBG_OUTPUT_PORT.printf("Auth Failed\n");
    else if (error == OTA_BEGIN_ERROR) DBG_OUTPUT_PORT.printf("Begin Failed\n");
    else if (error == OTA_CONNECT_ERROR)
      DBG_OUTPUT_PORT.printf("Connect Failed\n");
    else if (error == OTA_RECEIVE_ERROR)
      DBG_OUTPUT_PORT.printf("Receive Failed\n");
    else if (error == OTA_END_ERROR) DBG_OUTPUT_PORT.printf("End Failed\n");
    displayStatus(1, "OTA Error[%u]", error);
  });
  ArduinoOTA.begin();
}


void loop(void) {
// deal with timer (SimpleTimer)
  timer.run();
// deal with http server.
  server.handleClient();
  ArduinoOTA.handle();
  if (dnsStarted) dnsServer.processNextRequest();
  if (DBG_OUTPUT_PORT.available()) {
    String line = DBG_OUTPUT_PORT.readStringUntil('\r');
    DBG_OUTPUT_PORT.printf("%s\n", line.c_str());

    char buf[100];
    line.toCharArray(buf, sizeof(buf));
    char *p = buf;
    char *str;
    char *args[10];
    int argc = 0;
    while ((str = strtok_r(p, " ", &p)) != NULL && argc < 10) {
      args[argc++] = str;
    }
    if (argc >= 3 && strcmp(args[0], "ap") == 0) {
      strncpy(ssid, args[1], sizeof(ssid));
      strncpy(password, args[2], sizeof(password));
      eeSave();
      doRestart();
    }
  }
}
