lawabb/ESPrinkler2/(commit log)

2018-07-05 Add master relay, remove SPI, add doc folder
    [ESPrinkler2.fzz]
2021-01-13 Add gerber files
